omsfah/IELET2111-task3-i2c_slave/Kretsskjema/kretsskjema.pdf

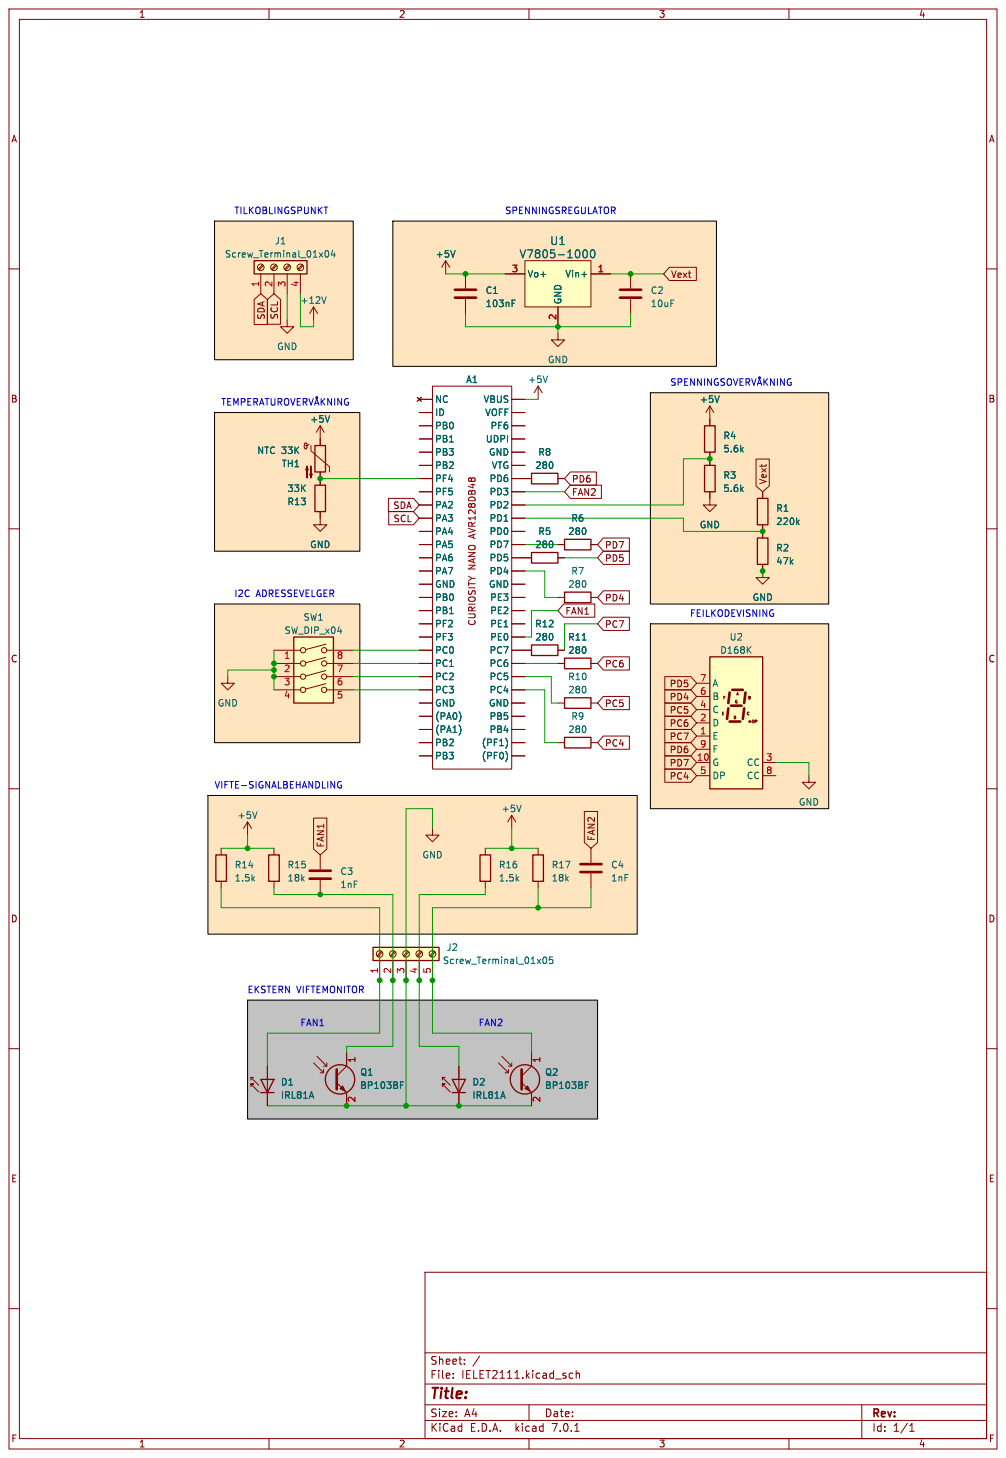
[picture p1: page 1]
