omsfah/IELET2111-task3-i2c_slave/Kretsskjema/IELET2111.kicad_sch

## KiCad design Kretsskjema/IELET2111.kicad_sch (2023-04-30, an earlier design)

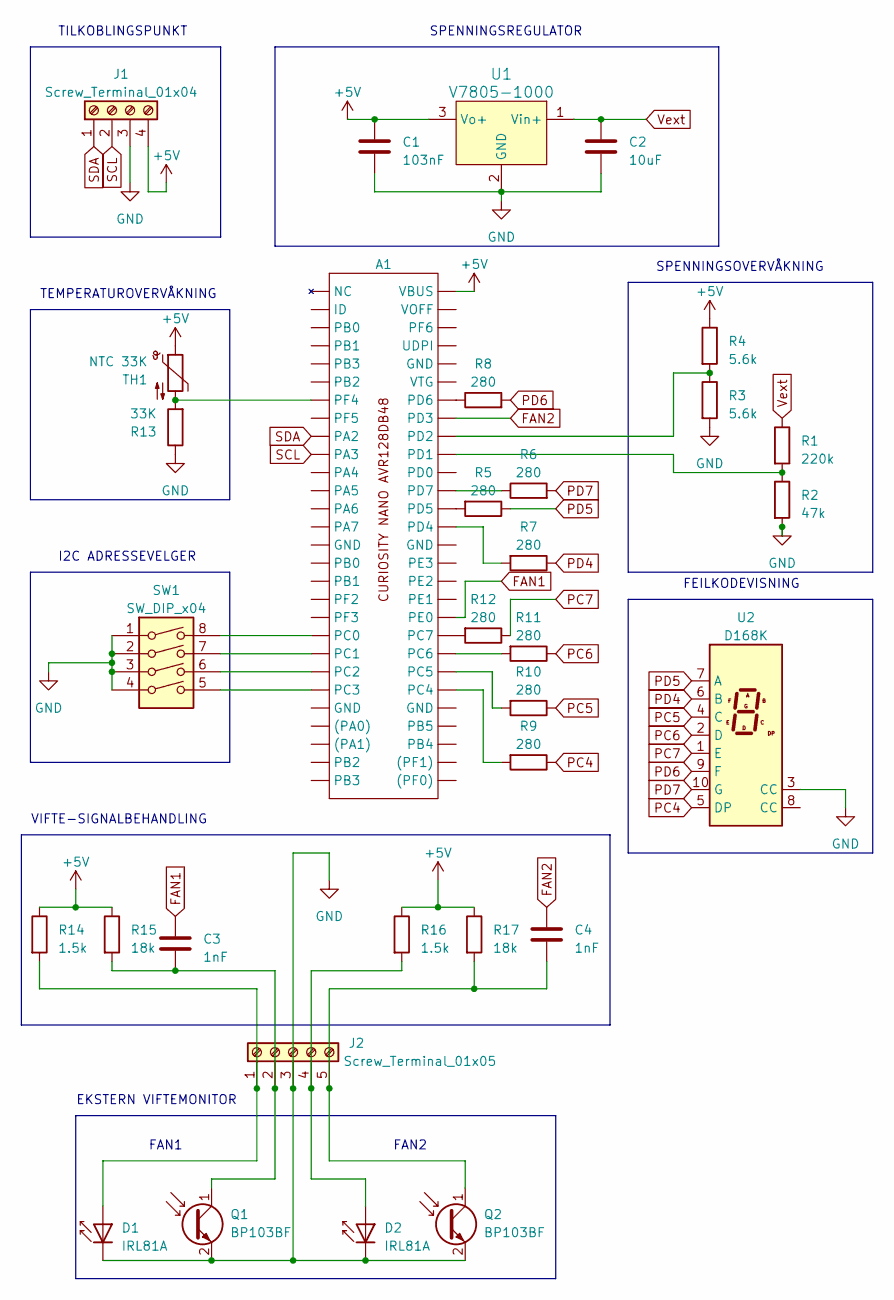
[picture p2: schematic IELET2111.kicad_sch]

Parts:
A1: (no value)
C1: 103nF
C2: 10uF
C3, C4: 1nF
D1, D2: IRL81A; LED_SideEmitter_Rectangular_W4.5mm_H1.6mm
J1: Screw_Terminal_01x04
J2: Screw_Terminal_01x05
Q1, Q2: BP103BF; LED_D5.0mm_Clear
R1: 220k
R2: 47k
R3, R4: 5.6k
R5, R6, R7, R8, R9, R10, R11, R12: 280
R13: 33K
R14, R16: 1.5k
R15, R17: 18k
SW1: SW_DIP_x04
TH1: NTC 33K
U1: V7805-1000; 3-SIP_Module_V7805-1000; MPN V7805-1000; Digi-Key_PN 102-1715-ND
U2: D168K; D1X8K

Connections:
+5V: A1., C1.1, J1.4, R4.1, R14.1, R15.1, R16.1, R17.1, TH1.1, U1.3 (Vo+)
FAN1: A1., C3.1
FAN2: A1., C4.1
GND: C1.2, C2.2, D1.1 (K), D2.1 (K), J1.3, J2.3, Q1.2 (E), Q2.2 (E), R2.2, R3.2, R13.1, SW1.1, SW1.2, SW1.3, SW1.4, U1.2 (GND), U2.3 (CC)
unnamed: A1., R1.2, R2.1, R3.1, R4.2, R5.2, R6.1, R7.2, R8.1, R9.2, R10.2, R11.2, R12.2, R13.2, SW1.5, SW1.6, SW1.7, SW1.8, TH1.2
unnamed: C3.2, J2.2, Q1.1 (C), R15.2
unnamed: C4.2, J2.5, Q2.1 (C), R17.2
unnamed: D1.2 (A), J2.1, R14.2
unnamed: D2.2 (A), J2.4, R16.2
PC4: R9.1, U2.5 (DP)
PC5: R10.1, U2.4 (C)
PC6: R11.1, U2.2 (D)
PC7: R12.1, U2.1 (E)
PD4: R7.1, U2.6 (B)
PD5: R5.1, U2.7 (A)
PD6: R8.2, U2.9 (F)
PD7: R6.2, U2.10 (G)
SCL: A1., J1.2
SDA: A1., J1.1
Vext: C2.1, R1.1, U1.1 (Vin+)

Notes on the sheet:
I2C ADRESSEVELGER
SPENNINGSREGULATOR
VIFTE-SIGNALBEHANDLING
SPENNINGSOVERVÅKNING
TILKOBLINGSPUNKT
FAN2
EKSTERN VIFTEMONITOR
FAN1
TEMPERATUROVERVÅKNING
FEILKODEVISNING
