omsfah/IELET2111-task3-i2c_slave/I2C-group7/hardware/system.c

#include "system.h"

/* Here we instantiate the global machine state data structure */
machine_state_t machine_state;


void SYSTEMS_init(void) {
    /* Main initialization procedure, ran at startup in 'main.c' */

    BUTTON_BUILTIN_init();
    LED_BUILTIN_init();
    DIP4_init();
    SEVEN_SEGMENT_init();
    FAN_MONITOR_init();
    RTC_UPTIME_COUNTER_init();

    USART3_init();
    stdout = &USART3_stream;

    // Generic ADC initializations
    ADC0_init(PORT_D, 1, SINGLE_CONVERSION_MODE);   // VEXT (External 12V supply)
    ADC0_init(PORT_D, 2, SINGLE_CONVERSION_MODE);   // VINT (Internal 5V supply)
    ADC0_init(PORT_F, 4, SINGLE_CONVERSION_MODE);   // TEMP (thermistor)

    // TODO: Init brownout detection
    // TODO: Init watchdog
}


void MACHINE_STATE_init(void) {
    /* This function is ran once on startup to initialize values
     * of the global 'machine_state' data structure. */

    // Restore threshold values that have been stored to EEPROM
    eepromRead(THRESHOLDS_EEPROM_ADDR, &machine_state.threshold, sizeof(machine_state.threshold));

    // Sample the size of 'machine_state'
    machine_state.machine_state_size = sizeof(machine_state);
}


void MACHINE_STATE_update(void) {
    /* Update 'machine_state' with new readings */

    // Check voltages
    machine_state.sensor_data.vext = VEXT_read();
    machine_state.sensor_data.vint = VINT_read();

    // Check Temperature
    machine_state.sensor_data.temp = THERMISTOR_read();

    // Check Fan RPM
    machine_state.sensor_data.fan1_freq = FAN_MONITOR_1_readFrequency();
    machine_state.sensor_data.fan2_freq = FAN_MONITOR_2_readFrequency();
    machine_state.sensor_data.fan1_span = FAN_MONITOR_1_readSpan();
    machine_state.sensor_data.fan2_span = FAN_MONITOR_2_readSpan();

    // Sample RTC for uptime
    machine_state.sensor_data.uptime = RTC_UPTIME_COUNTER_read();

    // Read DIP-switch
    machine_state.sensor_data.dip_switch = DIP4_read();
    machine_state.machine_state_size = sizeof(machine_state);

    // Sample the reset flag register
    machine_state.reset_flag_register = RSTCTRL.RSTFR;
}


void ALARM_SYSTEM_update(void) {
    /* Based on the current 'machine_state', decide
     * 'error_code' and whether or not to sound the
     * buzzer alarm */

    // Decide action for the alarm state machine
    switch (machine_state.buzzer_state) {
        case BUZZER_OFF:
            // TODO: Ensure the alarm is not on
        break;
        case BUZZER_CONSTANT_ON:
            // TODO: Write a tone to the buzzer
        break;
        case BUZZER_SUMMED:
        break;
    }

    machine_state.error_code_has_changed = false;

    // Error code decision. The last code to be checked will be standing in case
    // of simultaneous errors.
    //
    // 0: First we assert there is no error
    machine_state.error_code = 0;

    // 1: checking temperature reading
    if (machine_state.sensor_data.temp > machine_state.threshold.TEMP_HIGH) {
        machine_state.error_code = ALARM_TEMPERATURE;
        machine_state.buzzer_state = BUZZER_CONSTANT_ON;
    }
    // TODO:
    // 2: ALARM_SINGLE_FAN_FAILURE
    // 3: ALARM_BOTH_FAN_FAILURE

    // 4: checking if external 12V voltage is too high
    if (machine_state.sensor_data.vext > machine_state.threshold.VEXT_HIGH) {
        machine_state.error_code = ALARM_VEXT_HIGH;
        machine_state.buzzer_state = BUZZER_CONSTANT_ON;
    }
    // 5: checking if external 12V voltage is too low
    if (machine_state.sensor_data.vext < machine_state.threshold.VEXT_LOW) {
        machine_state.error_code = ALARM_VEXT_LOW;
        machine_state.buzzer_state = BUZZER_CONSTANT_ON;
    }
    // 6: checking if internal, regulated 5V voltage is too high
    if (machine_state.sensor_data.vint > machine_state.threshold.VINT_HIGH) {
        machine_state.error_code = ALARM_VINT_HIGH;
        machine_state.buzzer_state = BUZZER_CONSTANT_ON;
    }
    // 7: checking if internal, regulated 5V voltage is too low
    if (machine_state.sensor_data.vext > machine_state.threshold.VINT_LOW) {
        machine_state.error_code = ALARM_VINT_LOW;
        machine_state.buzzer_state = BUZZER_CONSTANT_ON;
    }
    // 8: checking if I2C communcation with controller has seized for too long
    if (machine_state.i2c_data.last_contact > machine_state.threshold.I2C_LASTCOMTIME) {
        machine_state.error_code = ALARM_I2C_NOCONTACT;
        machine_state.buzzer_state = BUZZER_CONSTANT_ON;
    }

    // If builtin button (PB2) was pushed, we sum (disable) the alarm sound
    if (machine_state.sensor_data.button_builtin == 1) {
        // FIXME: we need some more logic here or the buzzer will instantly
        //        turn back on.
        machine_state.buzzer_state = BUZZER_SUMMED;

        // We also reset the reset flag register when the button is pressed
        RSTCTRL.RSTFR = RSTCTRL_PORF_bm | RSTCTRL_BORF_bm | RSTCTRL_EXTRF_bm
                                        | RSTCTRL_SWRF_bm | RSTCTRL_UPDIRF_bm;
    }

    // Finally we write error code to the seven segment display
    // TODO: if (machine_state.error_code_has_changed)
    SEVEN_SEGMENT_showNumber(machine_state.error_code);
}
