omsfah/IELET2111-task3-i2c_slave/I2C-group7/hardware/dip-switch.c

#include "dip-switch.h"


void DIP4_init(void) {
    /* Initialize the 4 bit DIP switch in pull up configuration */
    PORTC.DIRCLR = PIN0_bm | PIN1_bm | PIN2_bm | PIN3_bm;
    PORTC.PINCONFIG = PORT_PULLUPEN_bm;
    PORTC.PINCTRLUPD = PIN0_bm | PIN1_bm | PIN2_bm | PIN3_bm;
}

uint8_t DIP4_read(void) {
    /* Reads an unsigned binary encoded integer from the
     * DIP switch. Least significant digit is to the right. */

    uint8_t temp = 15;
    if (PORTC.IN & PIN3_bm) {
        temp -= 1;  // LSB
    }
    if (PORTC.IN & PIN2_bm) {
        temp -= 2;
    }
    if (PORTC.IN & PIN1_bm) {
        temp -= 4;
    }
    if (PORTC.IN & PIN0_bm) {
        temp -= 8;  // MSB
    }
    return temp;
}
