omsfah/IELET2111-task3-i2c_slave/(commit log)

2023-03-22 Add ESP32 I2C master to USART bridge
2023-04-11 Add TWI functionality for I2C Target
2023-04-12 Add files and outline/comments for MVP
    To avoid "main.c" growing too large, specific hardware
    abstractions and communication routines are put in their
    own folders.
    [I2C.c, I2C.h, init.c, init.h, main.c, read.c]
2023-04-14 Add global configuration file
    [configuration.h]
2023-04-14 Add function prototypes for specific I2C procedure
2023-04-14 Work on the I2C procedure
2023-04-14 Fixed issues with solution explorer
    Added file structure to a MCNP project and edited file paths.
    [configuration.h]
2023-04-14 Fixed git ignore issue
    [main.c]
2023-04-16 Parametric ADC
    Might implement init in read with a check
2023-04-17 Change I2C-controller test sketch to multi-byte
2023-04-17 Add logging macro so we can toggle printing
2023-04-17 Fix I2C communication
    Breaking bug was in the address match ack part
    of the interrupt service routine in 'twi.c'.
    [configuration.h]
2023-04-17 Implement demo of i2c in main loop
2023-04-18 Add DIP switch init and read
2023-04-18 Add driver and demo for seven segment display
2023-04-19 Refactor main.c to init.c, add datastructure.h
    [configuration.h]
2023-04-19 Prepare for I2C packet system integration
2023-04-22 Rewrite and document TWI interrupt routine
2023-04-24 Continue work on multi-byte I2C
2023-04-24 Implement fan monitoring
    The frequency of the two fans can now be read (smoothed
    by a low pass filter). The span of the last values can also
    be read and used to determine if the fans have stopped.
2023-04-25 Fix microchip studio building
    [fan-monitor.h]
2023-04-25 Add preliminary alert and error report system
    [I2C.c, datastructure.h, system.c]
2023-04-25 Add debug tools for large package I2C communication
2023-04-25 Implement I2C command system
2023-04-26 Fix I2C issue 1: evsys channel 1 crash
    This also enables us to use the fan monitoring system
    at the same time as communicating over I2C.
    [datastructure.h, fan-monitor.c, fan-monitor.h, system.c]
2023-04-26 Fix I2C issue 2: ISR in twi.c timeout
    [configuration.h]
2023-04-26 Remove old tests from esp32 I2C controller sketch
2023-04-26 Work on I2C command handling
2023-04-27 Improvement of I2C and begin adding tests
2023-04-27 ADC, Thermistor and voltage
    Added libraries for measuring the peripherals, and outputting in a reasonable format.
2023-04-27 Simplify I2C_parseCommand with a macro + I2C bugfix
    We didn't call memset everywhere, and now the macro makes
    it easier (and more than halves the line lengths). This
    fixes the last I2C issue on my list.
    [I2C.c]
2023-04-27 Rework I2C commands + cpp compatibility of datastructures.h
    [I2C.c, I2C.h, datastructure.h, system.c]
2023-04-27 Add parsing of the received data on ESP32
2023-04-28 Integrate temperature reading into main program
2023-04-28 Integrate voltage readings in the main program
2023-04-28 Various small changes
    Add units to all data fields for ESP32.
    Integrate the missing timer variables with the new RTC lib.
    [I2C.c, datastructure.h, main.cpp]
2023-04-29 Add saving of default values to EEPROM
    [configuration.h]
2023-04-29 Add factory reset command
    [configuration.h]
2023-04-29 Offset I2C commands to make room for future commands
2023-04-29 Not a big fan
2023-04-30 Add I2C commands for setting pullups on the bus
2023-04-30 Add project and author description to header files
    [configuration.h]
2023-04-30 Lastet opp kretsskjema
    [IELET2111.kicad_pcb, IELET2111.kicad_sch]
2023-04-30 Fikset sjekk på ADC init
2023-04-30 Work on I2C and fan issues
    [I2C.c, I2C.h, datastructure.h, fan-monitor.c, main.c]
2023-04-30 Endringer på kicad filer
    [IELET2111.kicad_sch]
2023-05-01 Remove some unused code, move configs to configuration.h
    [configuration.h]
